truglodite/BLDynoMega/changelog.md

# BL Dyno Mega Change-log

# dev - Current development
Add 20x4 I2C LCD UI.

# 0.1 - Initial commit
Basic 3 button interface with rare, calibrate, and run modes. Serial output data, and throttle pot input. All tested and working well.
